JuKimpfler/ClassE_LowVoltage_SSTC/PCB/Audio Bord.pdf

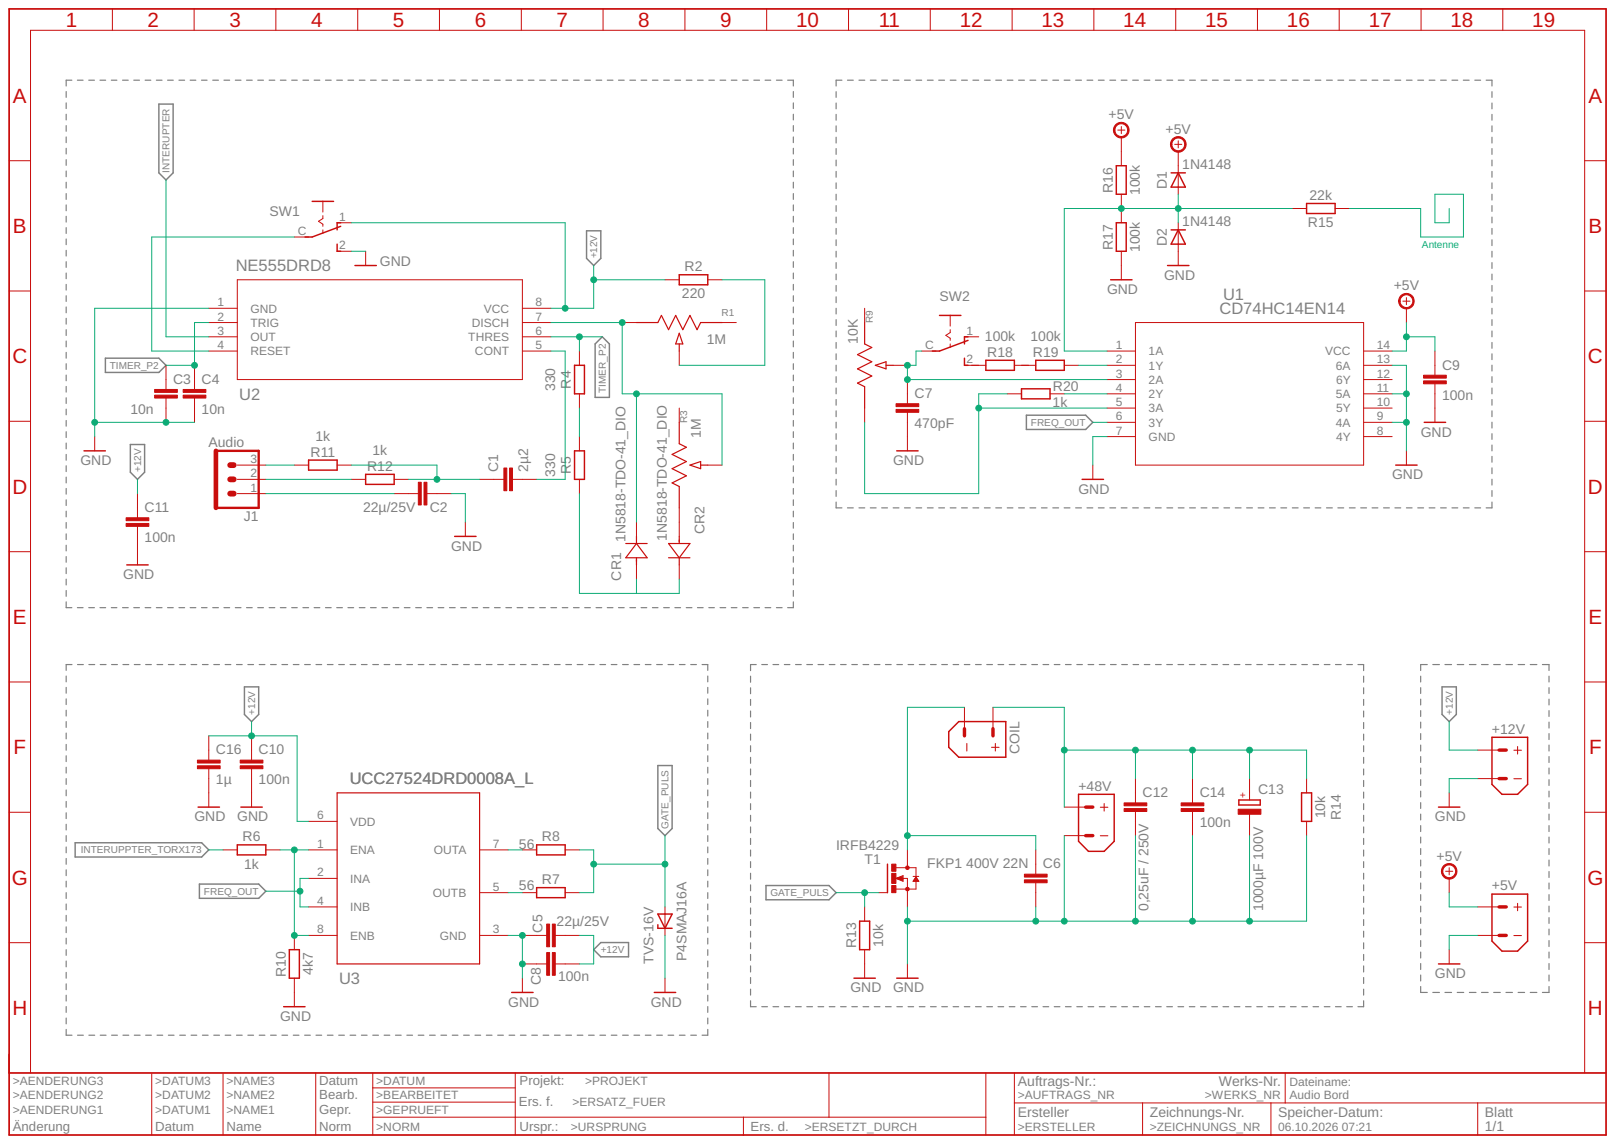
[picture p1: page 2]
