JuKimpfler/ClassE_LowVoltage_SSTC/PCB/Audio Bord.sch

## EAGLE design PCB/Audio Bord.sch (2026-10-06)

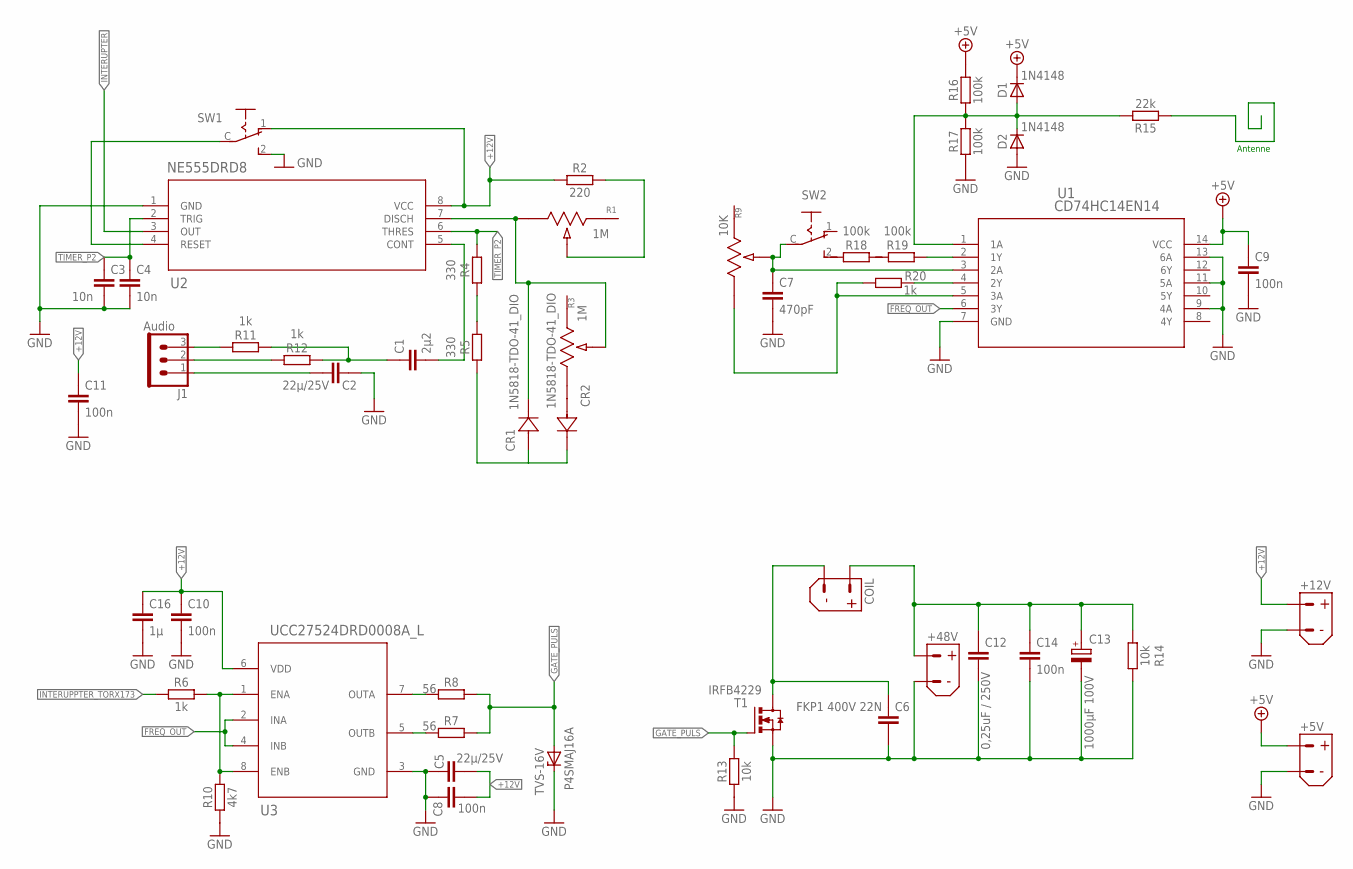
[picture p2: schematic Audio Bord.sch]

Parts:
+5V, +12V, +48V: XT60UPB-M
C1: 2µ2; C1206
C2, C5: 22µ/25V; C1206
C3, C4: 10n; C0603
C6: FKP1 400V 22N; C1206
C7: 470pF; C1206
C8, C9, C10, C11, C14: 100n; C1206
C12: 0,25uF / 250V; C1206
C13: 1000µF 100V; E2-5
C16: 1µ; C1206
COIL: XT60UPB-M
CR1, CR2: 1N5818-TDO-41_DIO; DO-41_DIO
D1, D2: 1N4148; SOD523
J1: Audio; PSS-03G
P4SMAJ16A: TVS-16V; DO214AC/SMA
R1, R3: 1M; POT_3296X
R2: 220; R1206
R4, R5: 330; R0805
R6, R11, R12, R20: 1k; R1206
R7, R8: 56; R1206
R9: 10K; POT_3296X
R10: 4k7; R1206
R13, R14: 10k; R1206
R15: 22k; R1206
R16, R17, R18, R19: 100k; R1206
SW1, SW2: SW_SPDT_ESP10; ESP10XX
T1: IRFB4229; PG-TO263-3
U1: CD74HC14EN14; N14
U2: NE555DRD8; D8
U3: UCC27524DRD0008A_L; D0008A_L

Connections:
+5V: +5V.+, C9.1, D1.C, R16.2, U1.14 (VCC)
+12V: +12V.+, C5.2, C8.2, C10.1, C11.1, C16.1, R2.1, SW1.1 (NC), U2.8 (VCC), U3.6 (VDD)
FREQ_OUT: U1.6 (3Y), U3.2 (INA), U3.4 (INB)
GATE_PULS: P4SMAJ16A.A, R7.2, R8.2, R13.2, T1.1 (G)
GND: +5V.-, +12V.-, +48V.-, C2.2, C3.2, C4.2, C5.1, C6.2, C7.2, C8.1, C9.2, C10.2, C11.2, C12.2, C13.-, C14.2, C16.2, D2.A, P4SMAJ16A.C, R10.1, R13.1, R14.1, R17.1, SW1.2 (NO), T1.3 (S), U1.7 (GND), U1.9 (4A), U1.11 (5A), U1.13 (6A), U2.1 (GND), U3.3 (GND)
INTERUPPTER_TORX173: R6.1
INTERUPTER: U2.3 (OUT)
unnamed: CR1.1, R1.3, R3.2, U2.7 (DISCH)
unnamed: R1.2, R2.2
unnamed: R19.2, U1.2 (1Y)
unnamed: R4.1, R5.2
unnamed: CR1.2, CR2.1, R5.1
unnamed: C1.2, U2.5 (CONT)
unnamed: R8.1, U3.7 (OUTA)
unnamed: R7.1, U3.5 (OUTB)
unnamed: C6.1, COIL.-, T1.4 (D)
unnamed: R9.3, R20.1, U1.5 (3A)
unnamed: J1.2, R12.1
unnamed: C2.1, J1.1
unnamed: CR2.2, R3.3
unnamed: +48V.+, C12.1, C13.+, C14.1, COIL.+, R14.2
unnamed: C1.1, R11.2, R12.2
unnamed: J1.3, R11.1
unnamed: D1.A, D2.C, R15.2, R16.1, R17.2, U1.1 (1A)
unnamed: C7.1, R9.2, SW2.C, U1.3 (2A)
unnamed: R20.2, U1.4 (2Y)
unnamed: SW1.C, U2.4 (RESET)
TIMER_P2: C3.1, C4.1, R4.2, U2.2 (TRIG), U2.6 (THRES)
UCC_P1: R6.2, R10.2, U3.1 (ENA), U3.8 (ENB)

Notes on the sheet:
Antenne
